siddhantjena13/shelf-life/enclosure/shelflife_lid_01.stl

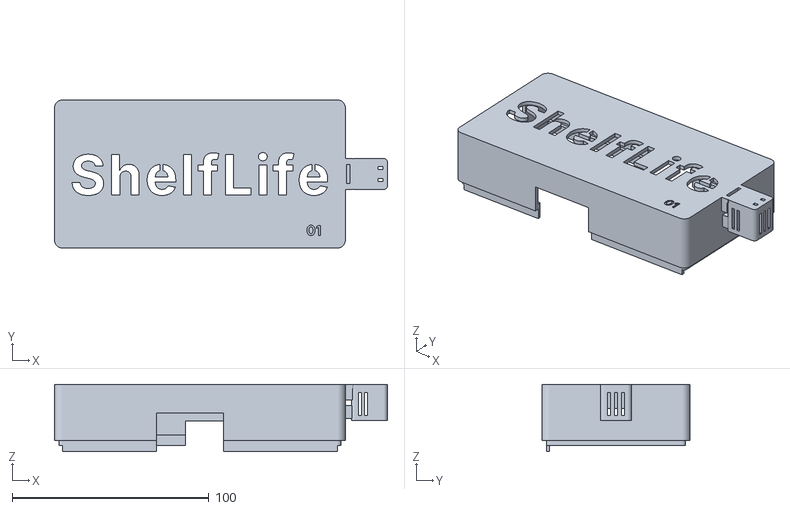
[picture p1: CAD file, 2026-10-19]
enclosure/shelflife_lid_01.stl
169.1 x 75.2 x 34.1
