siddhantjena13/shelf-life/enclosure/shelflife_shelf_v5.stl

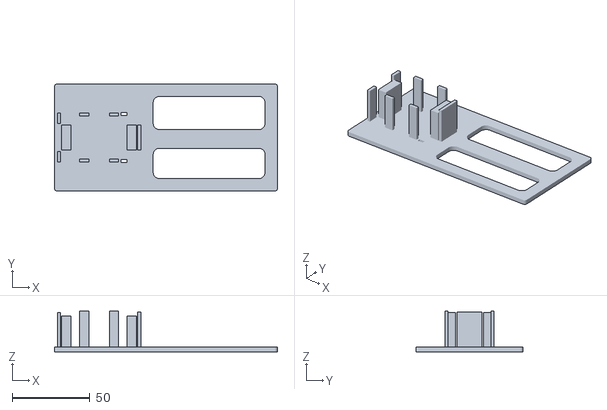
[picture p2: CAD file, 2026-10-19]
enclosure/shelflife_shelf_v5.stl
143.1 x 68.8 x 26.1
