siddhantjena13/shelf-life/enclosure/shelflife_base.stl

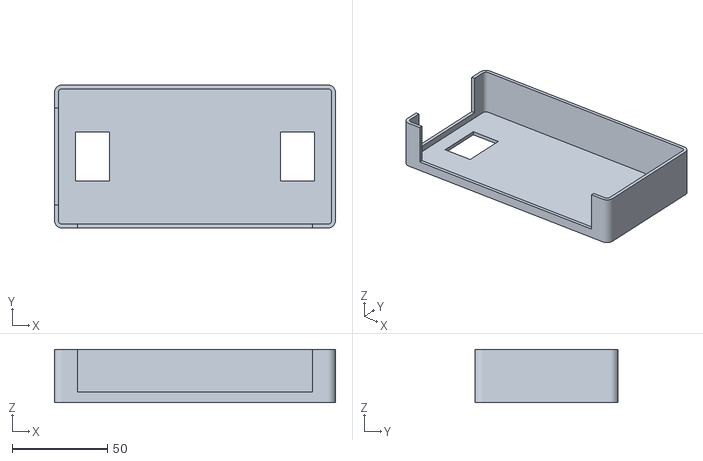
[picture p3: CAD file, 2026-10-19]
enclosure/shelflife_base.stl
147.7 x 75.2 x 28.0
