siddhantjena13/shelf-life/(commit log)

2026-10-13 Add dashboard frontend with simulated live readings
    React + Vite dashboard showing storage conditions, inventory risk,
    live temperature and humidity history, recommendations and summary
    tiles. Readings come from an in-browser simulator behind a single
    data source module, ready to be pointed at the backend. Includes a
    light/dark theme switch.
2026-10-15 Add risk engine for four food profiles
    Cumulative-exposure model: a per-item shelf-life clock driven by the
    Ratkowsky square-root model on the food's estimated temperature, a
    humidity factor for greens and strawberries (including condensation),
    and the USDA 2-hour rule. Profiles cite their sources; HOW_IT_WORKS.md
    explains the choices in plain language.
2026-10-17 Build inventory sensors and alerts dashboard tabs
2026-10-17 Stream live ESP32 sensor readings to the dashboard
    - backend/readings.py: POST /api/readings (ESP32), GET /api/readings and
    /api/devices, stored in SQLite; device -> zone mapping
    - frontend: live polling data source (default), ?source=sim for the simulator,
    dev server reachable from other devices on the network
    - firmware/shelflife_sensor: SHT31 + Wi-Fi sketch, credentials in git-ignored secrets.h
    - HARDWARE.md: setup for laptop + hotspot + iPad demo
2026-10-17 Add photo food inventory API with Perceptron Mk1.5 and SQLite
    Inventory items, freshness checks and photos are stored in a local
    SQLite file by default, or MongoDB when MONGODB_URI is set. Perceptron
    Mk1.5 suggests food, visible freshness and printed dates from a photo;
    suggestions are never saved without the user confirming them.
2026-10-17 Add camera logging, re-logging and a photo inventory page
    Log food with a live camera or uploaded photo, review and edit what
    Perceptron suggests, and re-log items later to build a freshness history.
    The inventory page shows photo cards sorted by what to use first, and
    items can be marked used or tossed.
    The new inventory page replaces the table-based Inventory tab. The
    Sensors and Alerts tabs are kept and now use the same hash routing, the
    Alerts tab also lists inventory alerts such as spoiled or expired food,
    and on phones a bottom bar with a camera button replaces the top tab
    strip.
2026-10-18 Estimate remaining shelf life with a Bayesian freshness model
    Combines the printed date, USDA FoodKeeper times, the zone's temperature
    and humidity history, and photo or manual freshness checks into a
    distribution of remaining shelf life: a median, a 10th-90th percentile
    range, the chance an item is already past its best, and a survival curve.
    - Produce ages on measured Arrhenius quality-loss rates instead of
    pathogen growth limits; meat and dairy keep the Ratkowsky model.
    - Humidity is tracked as transpiration water loss against wilting limits.
    - Each check reweights the scenarios; unobserved time widens the range.
    - The 2-hour rule counts time above 41°F, the FDA Food Code limit.
    Cons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
2026-10-18 Show the freshness estimate in the inventory and dashboard
    The item drawer shows the time left with its likely range, a
    chance-it's-still-good curve and what went into the estimate. Cards and
    the dashboard table show time left. Assessments now send printed dates
    and freshness checks to the model.
2026-10-18 Keep ESP32 Wi-Fi awake so power banks don't switch off
2026-10-18 Support MongoDB Atlas for sensor data with SQLite fallback
2026-10-18 Document Arindam Sanyal's previous contributions
    The following commits were made by Arindam Sanyal (GitHub: sanyalarindam) using the local Git author name s-asanyal and a placeholder email:
    ab193ce - Removed hi.txt.
    fe403a2 - Standardized ShelfLife branding and migrated saved browser inventory and theme data.
    de3950c - Updated the README with completed hackathon MVP features, including the freshness model and live cooler demonstration.
    eca4087 - Added MongoDB Atlas sensor storage while retaining SQLite support.
    81949e7 - Added Arindam Sanyal, Vineeth Rajesh, and Siddhant Jena to the README team list.
    b43d29b - Made SQLite the default demo database, retained explicit MongoDB opt-in, and adde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
2026-10-18 Show Waiting when sensor temperatures are unavailable
2026-10-18 Refresh freshness assessments without new sensor readings
2026-10-18 Load complete sensor history and summarize readings for scoring
2026-10-18 Highlight sensor mode and clarify estimated freshness labels
2026-10-19 Add 3D-printable enclosure STL files
